denilsonsa/retroadapter/more_docs/denki.world3.net/img/retro/production02_t.jpg

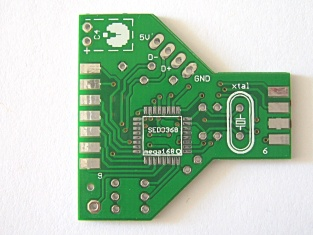
more_docs/denki.world3.net/img/retro/production02_t.jpg
