denilsonsa/retroadapter/more_docs/Retro Adapter connections - Sheet1.pdf

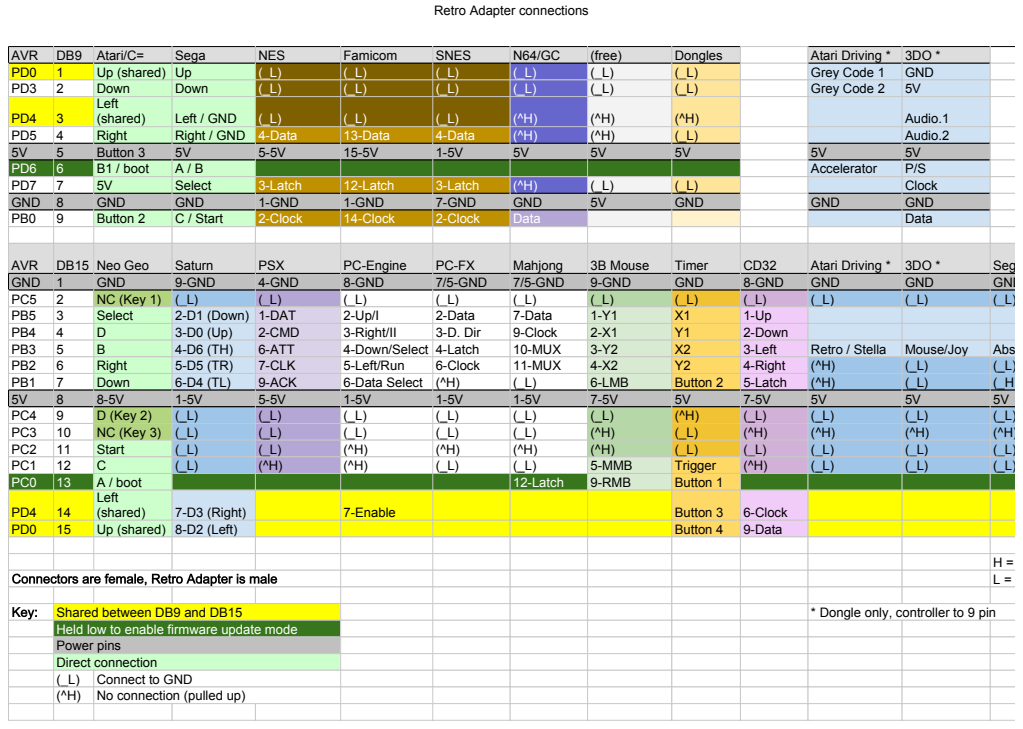
[picture p3: page 1]
AVR; Atari/C=; Sega; NES; Famicom; SNES; (free); Dongles; Atari Driving *; Up (shared); Grey Code 1; GND; Down; Grey Code 2; Left; (shared); Left / GND; Audio.1; Right; Right / GND; 4-Data; 13-Data; Audio.2; Button 3; B1 / boot; Accelerator; Select; 3-Latch; 12-Latch; Clock; 1-GND; 7-GND; Button 2; C / Start; 2-Clock; 14-Clock; Data; Neo Geo; Saturn; PSX; PC-Engine; Mahjong; 3B Mouse; Timer; Sega Paddle *; 9-GND; 4-GND; 8-GND; 7/5-GND; NC (Key 1); 2-D1 (Down); 1-DAT; 2-Data; 7-Data; 2-CMD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

Retro Adapter connections

Held low to enable firmware update mode
Power pins
Direct connection

Coleco * | Odyssey 2 | GX4000
1 Col 1 | 6-Up | 1-Up
2 Col 2 | 4-Down | 2-Down
3 Col 3 | 3-Left | 3-Left
4 Col 4 | 5-Right | 4-Right
| | 5-NC (Button 3)
Button | 2-Button | 6-Button 2
Quad A
| 1-GND | 8-GND
Quad B | | 7-Button 1
Sega Paddle * | Coleco * | BBC Micro | Voltmace | BitStik | Dragon 32/64 | Atari Jaguar | Dual Atari/Sega | Dual NES/SNES | AVR | DB15
GND | GND | 8-GND | 8-GND | 8-GND | 3-GND | 9-GND | 8-GND | 8-GND | GND | 1
(_L) | (_L) | (^H) | (^H) | (^H) | (^H) | (^H) | (_L) | (_L) | PC5 | 2
| | 2 0V | 2 COL0 | 2 0V | | 1-Column 1 | 1-Up | (_L) | PB5 | 3
| 5-Select | 3 0V | 3 COL1 | 3 0V | | 2-Column 2 | 2-Down | (_L) | PB4 | 4
Abs/Rel | 8-Select | 5 0V | 5 COL2 | 5 0V | | 3-Column 3 | 3-Left | (_L) | PB3 | 5
(_L) | (_H) | 6 0V | 6 ROW1 | 6 0V | | 4-Column 4 | 4-Right | 4-Data | PB2 | 6
(_H) | (_L) | 10 B2 | 10 ROW2 | 10 L button | 4-Fire 2 | 6-Row 1 | 6-B1 or A/B | | PB1 | 7
5V | 5V | 1 5V | 1 5V | 1 5V | 5-5V | 5-5V | 5-5V | 5-5V | 5V | 8
(_L) | (_L) | 7 AD1 1Y | 7 AD1 Y | 7 AD1 Y axis | 2-Y1 Wiper | (_L) | (^H) | (^H) | PC4 | 9
(^H) | (^H) | (_L) | (_L) | (_L) | (_L) | (^H) | (^H) | (^H) | PC3 | 10
(_L) | (_L) | 15 AD2 1X | 15 AD2 X | 15 AD2 X axis | 1-X1 Wiper | 10-Row 2 | 7-5V or Select | 3-Latch | PC2 | 11
(_L) | (_L) | 12 AD3 2X | 12 N/C | 12 AD3 Z axis | 1-X2 Wiper | 11-Row 3 | 9-B2 or C/Start | 2-Clock | PC1 | 12
| | 4 AD4 2Y | 4 ROW0 | 4 R button | 2-Y2 Wiper | 12-Row 4 | | | PC0 | 13
| | 13 B1 | 13 ROW3 | 13 Red button | 4-Fire 1 | 13-Row 5 | | | PD4 | 14
| | (^H) | (_L) | (^H) | (^H) | 14-Row 6 | | | PD0 | 15
H = Abs | 11/14 VREF (5V)
L = Rel | 9 N/C | Dongle | DB15
Female DB15 on BBC Micro | | GND (_L) | 1 2 3
| | | | | 4
| | | | | 5
| | | | | 6
| | | | | 7
| | | | 5V | 8

White | Connector Colour Chart | Dongle Colour Chart
Brown | Connector | Shell | Colour | Connector | Shell | Colour
Purple | 2 Player | DB15-DB9 | White | BitStik | DB9 | Orange
Green | Atari Paddles | DB15-DB9 | Brown
Yellow | CD32 | DB15-DB9 | Purple | Atari Driving | DB15 | Brown
Blue | Amiga Mouse | DB15-DB9 | Green | 3DO | DB15 | Purple
Gold | Atari Mouse | DB15-DB9 | Yellow | Sega Paddles | DB15 | Green
Silver | Jaguar | DB15-HD15 | Orange | Colecovision | DB15 | Blue
Orange | Famicom | DB9-DB15 | Blue
Red | | | | Update | DB15/DB9 | Red
Black | Odyssey 2 | DB9-DB9 | Gold
Grey | Amstrad
| GX4K | DB9-DB9 | Silver
| Channel F | DB9-DB9 | Purple
| BBC/Voltmace | DB15-DB15 | Orange
| PC Gameport | DB15-DB15 | Yellow
| Dragon 32/64 | DIN 5 | Red
| PC-Engine | Mini DIN 8 | Green
| Intellivision | Pin header | Yellow
| Acorn Mouse | Mini DIN 9 | Orange

| Archimedes Mouse (MiniDIN) | | Intellivision | AVR | | (_L) | 9 10
Orange | | 2 | Button 1 | | (^H) | PC5 | | (_L) | 12
| | 3 | Button 2 | | 2-Red | PB5 | | | 13
Brown | | 4 | GND | | 3-Orange | PB4 | | | 14
Purple | | 5 | XDIR | | 4-Yellow | PB3 | | | 15
Green | | 6 | 5V | | 5-Green | PB2
Blue | | 7 | YREF | | 6-Blue | PB1
| | 8 | Button 3 | | (unused) | 5V
Red | | 9 | YDIR | | (^H) | PC4
| | | | | (^H) | PC3
| | BBC Micro Mouse (20 pin) | | | 7-Black | PC2
| | 1 | 5V | | 8-Grey | PC1
| | 3 | GND | | 9-White | PC0
| | 11 | X1 | | | PD4
| | 12 | Y1 | | | PD0
| | 13 | X2
| | 15 | Y2
| | 18 | Right button
| | 19 | Middle button
| | 20 | Left button
Colour | 1 | XREF | 1-Brown | GND | (_L) | 11
