denilsonsa/retroadapter/hardware/retroadapter_atmega8.png

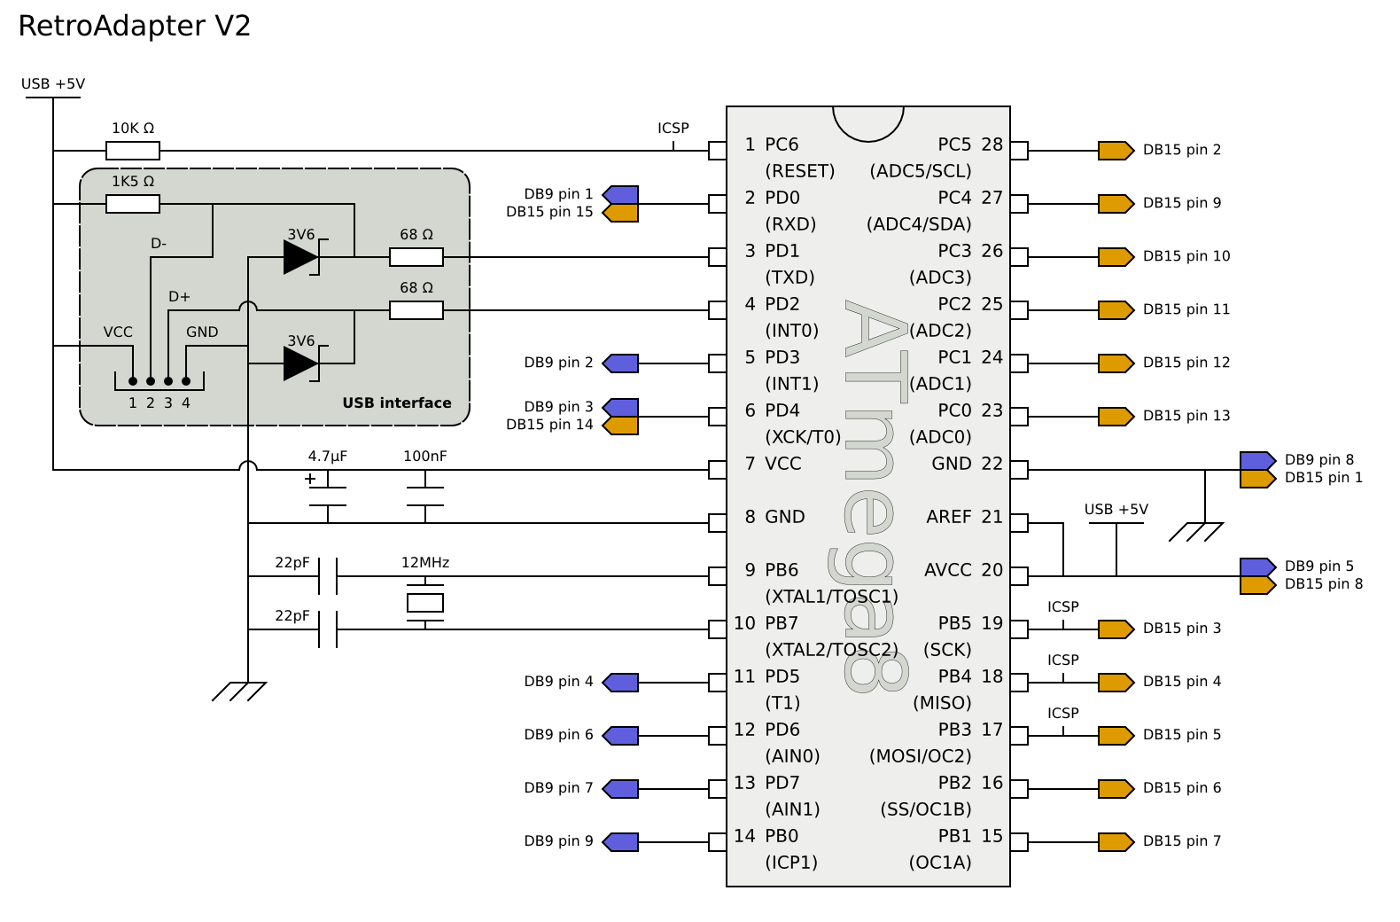
hardware/retroadapter_atmega8.png
