denilsonsa/retroadapter/more_docs/denki.world3.net/img/retro/pcb-final-01_t.png

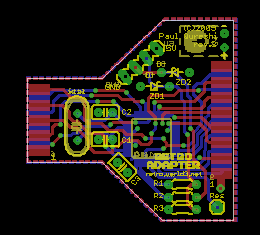
more_docs/denki.world3.net/img/retro/pcb-final-01_t.png
