denilsonsa/retroadapter/more_docs/denki.world3.net/img/retro/rev312_t.jpg

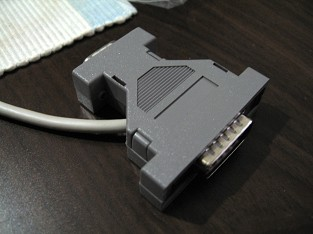
more_docs/denki.world3.net/img/retro/rev312_t.jpg
