denilsonsa/retroadapter/more_docs/denki.world3.net/img/retro/rev313_t.jpg

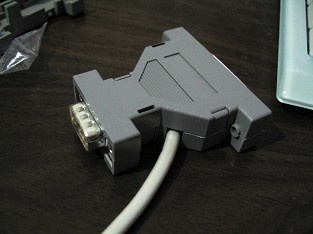
more_docs/denki.world3.net/img/retro/rev313_t.jpg
