denilsonsa/retroadapter/more_docs/denki.world3.net/img/retro/sch-ataripaddles_t.png

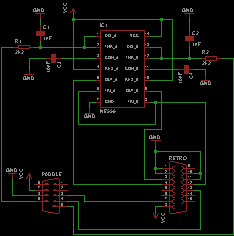
more_docs/denki.world3.net/img/retro/sch-ataripaddles_t.png
