denilsonsa/retroadapter/more_docs/denki.world3.net/img/retro/schematic_bt.png

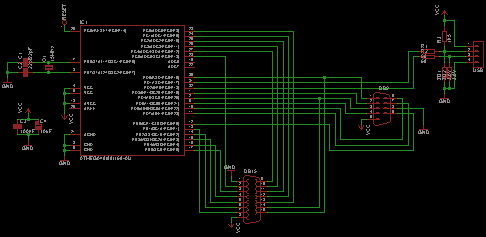
more_docs/denki.world3.net/img/retro/schematic_bt.png
