denilsonsa/retroadapter/(commit log)

2013-06-23 Importing RetroAdapter 2.1a
    [Retro Adapter V2 1.0.brd, Retro Adapter V2 1.0.sch]
2013-06-23 Updating V-USB driver from 2009-08-22 to 2010-07-15.
    Also fixes a compile error related to SIG_INTERRUPT0 and INT0_vect names.
    [usbconfig.h]
2013-06-23 Removed all mouse support.
    If I actually want to use a Mouse, I'll use a real USB mouse, which will
    certainly work better than any old console mouse (Amiga or SNES). In addition,
    I don't have and I won't acquire any console mice.
    Now the firmware size is 5826 bytes.
    [RetroAdapterV2.c, descriptors.h, famicom.c, famicom.h]
2013-06-23 PCICR (external interrupts) are only used by Amiga mouse support.
2013-06-24 Hard-coding 3 input bits to some values.
    The adapter I'm building will use two DB9 connectors. Some of the extra pins
    from the DB15 connector work as mode-selection (actually, a controller-type
    detection) and their values are hard-wired in the DB15-to-controller adapter.
    Since I'm only interesting in one kind of controller, I can hard-code this
    controller detection in the firmware. After all, software/firmware is way
    easier to change than hardware.
2013-06-24 Adding avrdude to the Makefile. Adding FUSE bits for ATmega8.
    And the device works! On the first try! Woohoo!
2013-07-06 Fixing Mega Drive (Genesis) Start/Mode button mapping.
    Issues fixed by this commit:
    * Start and Mode were mapped to the same button on the second controller.
    * Start and Mode were mapping was not consistent between the first and the second controller.
    [direct.c, dualdb9.c]
2013-07-06 Updating V-USB driver from version 2009-08-03 to version 2012-07-09.
2013-07-06 Fixing some warnings/errors from gcc 4.6.
    [RetroAdapterV2.c, descriptors.h, timers.c]
2013-07-06 Tweaking the bootloader to my needs.
    Still has a compiler warning (that can be ignored, apparently):
    ../usbdrv/usbdrv.h:223:24: warning: ‘usbFunctionDescriptor’ used but never defined [enabled by default]
2013-07-15 Adding schematic diagrams for this project.
2024-01-11 Added the useful `checksize` script
    Copied over from
    https://github.com/denilsonsa/atmega8-magnetometer-usb-mouse/blob/master/firmware/checksize
    and originally from `HIDKeys.2007-03-29.tar.gz`.
2024-01-13 Small reorganization to make it easier for people new to the project
    Moved some legacy (probably obsolete) files into a legacy directory.
    Re-written portions of `fuse.txt` and `README.md`. Oh, and converted the
    README from a plain text file to a markdown file.
2024-01-13 Renamed Hardware and Source directories to lower-case
    [Retro Adapter V2 1.0.brd, Retro Adapter V2 1.0.sch]
